mgottschlag/tiltrotor-uav/software/firmware/README.md

# Flightcontroller

## Setup on Archlinux

```bash
sudo pacman -S stlink
```

## Build and Run

```bash
# build
cargo build-flightcontroller

# run
cargo run-flightcontroller
```
