mgottschlag/tiltrotor-uav/doc/pre-design/pre-design.pdf

# Pre-Design of the Tiltrotor UAV

## 18th July 2021

## Contents

1 Requirements | 2
2 Overall Design | 2
3 Wing Design | 2
4 Empennage Design | 3

1

## 1 Requirements

- The UAV shall be able to take off and land vertically.
- The UAV shall be able to transition from the vertical flight to the horizontal flight and vice versa.
- The UAV shall fit into the Category C0 (privately built) [1]:

– The UAV shall have a MTOW of less than 250 g.
– The UAV shall have a maximum speed of less than 19 m s⁻¹ .
•

### 1.1 Vertical Flight

- Vertical flight only necessary for take-off and landing
- No fast manoeuvres necessary

### 1.2 Horizontal Flight

- The UAV shall be optimized for efficient flight at slow speed.
- The manoeuvrability shall suffice for basic manoeuvres. The ability to perform acrobatics is not necessary.

## 2 Overall Design

- The basic design is a conventional layout with a high wing with a high aspect ratio and a conventional tailplane.
- The motors are situated in front and in the back of the wing.
- The motors can be turned to perform the transition between vertical and horizontal flight.
- The UAV is controlled using a rudder and an elevator. There are no ailerons.

## 3 Wing Design

- Wing properties:

– High aspect ratio for good efficiency.

– Rectangular planform with tapered tips. Reason:

2

b

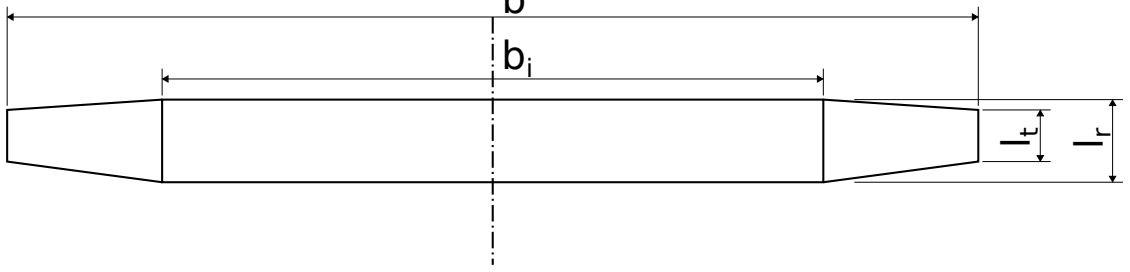
[picture p3: figure]

Figure 1: Wing planform

– The main part of the wing has no dihedral. Only the wing tips have a mod-erate dihedral as needed for stability.

- Wing surface:

S = bi

- lr +

b − bi
2

·

lr + lt
2
- Wing aspect ratio:
Λ = b

2
S
- Relative mean chord:
lµ = lr

This is only correct if the wing tips have no sweep.

## 4 Empennage Design

- The initial sizing of the empennage is done with the formulas given by Raymer [2,
p. 112].
- Both the vertical and horizontal tailplanes have a swept back leading edge and a straight trailing edge.
- Length of the mean aerodynamic chord with λi =

Lt,i

Lr,i

:

Lµ,i =

2
3
- Lr,i ·

1 + λi + λ

2
i
1 + λi
- y-position of the mean aerodynamic chord:

ylmu,i =

bi
6

·

1 + 2 · λi
1 + λi

3

### 4.1 Vertical Tail

SV T =

cV T · b · S

LV T
- The volume coefficient for the vertical tail is chosen as the one of a sailplane (cV T = 0.02).

### 4.2 Horizontal Tail

SHT =

cHT · lµ · S

LV T
- The volume coefficient for the horizontal tail is chosen as the one of a sailplane (cV T = 0.50).
- LV T is the distance of the 1
4

-point of the mean aerodynamic chord of the horizontal tailplane to the centre of gravity.

- lmu is the length of the mean aerodynamic chord of the horizontal tailplane.

4

## References

[1] Luftfahrt-Bundesamt. (). “Fragen und antworten zum eu-drohnenf¨uhrerschein,”
[Online]. Available: https://www.lba.de/DE/Betrieb/Unbemannte_Luftfahrtsysteme/FAQ/02_EU_Drohnenfuehrerschein/FAQ_node.html;jsessionid=3AB85C850216B1BFEEDFD691CD034F57. live21304 (https://www.lba.de/DE/Betrieb/Unbemannte_Luftfahrtsysteme/FAQ/02_EU_Drohnenfuehrerschein/FAQ_node.html;jsessionid=3AB85C850216B1BFEEDFD691CD034F57.live21304) (visited on 17/07/2021).
[2] D. P. Raymer, Aircraft Design: A Conceptual Approach. Washington, DC: American
Institute of Aeronautics ans Astronautics, Inc., 1992.

5
