mgottschlag/tiltrotor-uav/doc/pre-design/fig/wing_planform.pdf

b

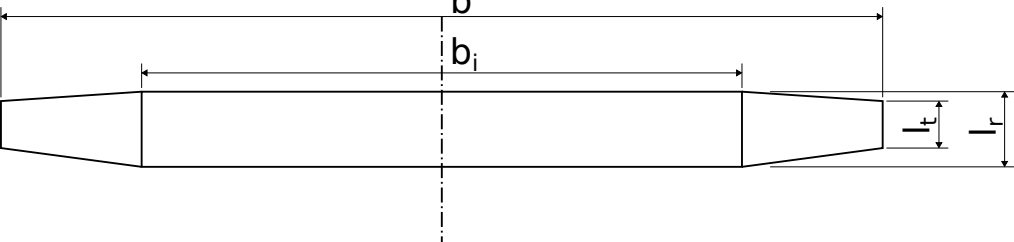
[picture p4: figure]
