mgottschlag/tiltrotor-uav/doc/pre-design/fig/Horizontal flight.PNG

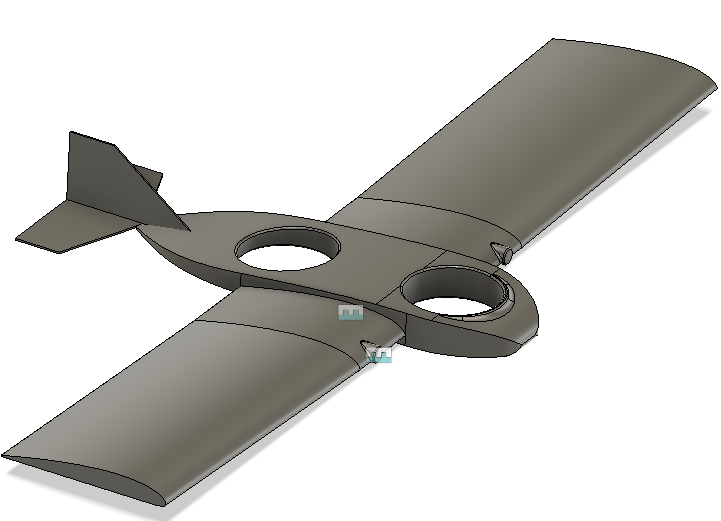
doc/pre-design/fig/Horizontal flight.PNG
