mgottschlag/tiltrotor-uav/doc/pre-design/fig/Vertical flight.PNG

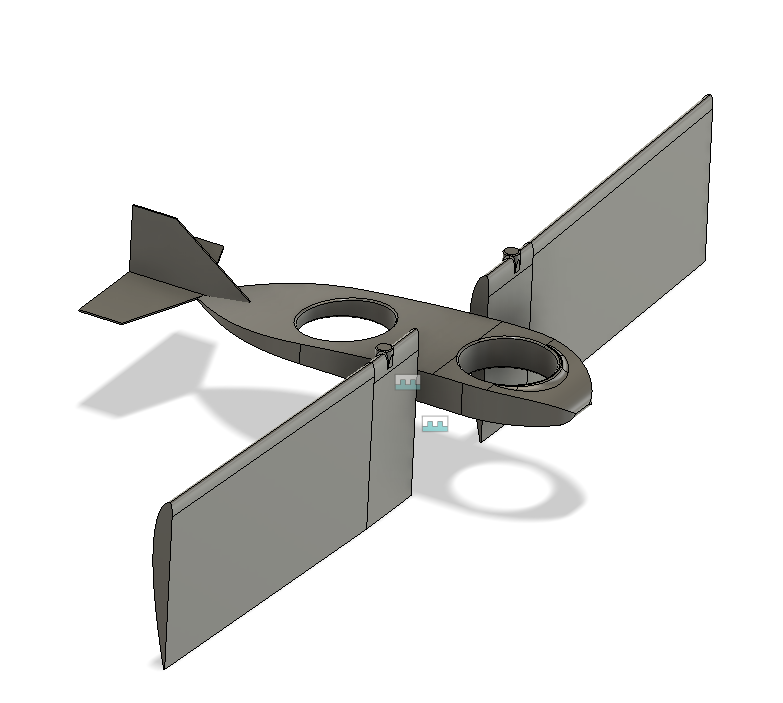
doc/pre-design/fig/Vertical flight.PNG
