mgottschlag/tiltrotor-uav/electronics/flightcontroller/flightcontroller.kicad_pcb

## KiCad design electronics/flightcontroller/flightcontroller.kicad_pcb (2024-06-04)

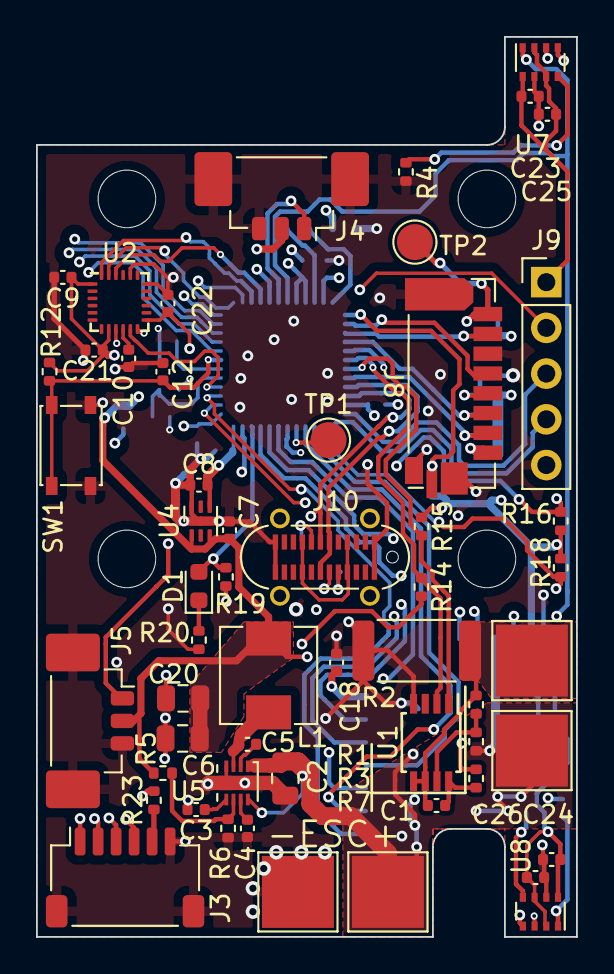
[picture p7: board flightcontroller.kicad_pcb from above]

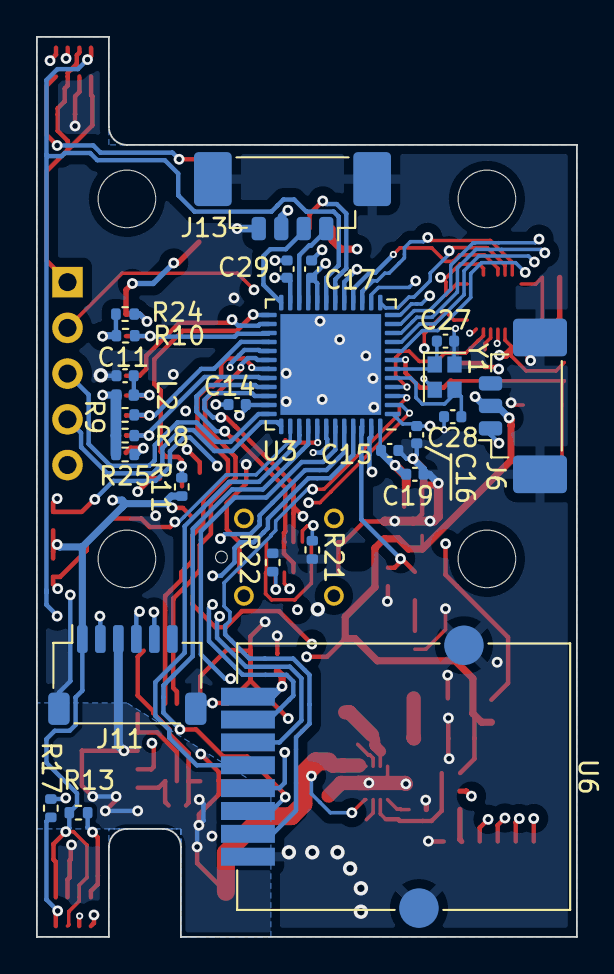
[picture p8: board flightcontroller.kicad_pcb from below]

Board: 4 copper layers, 30.0 x 50.0 mm, 85 parts (26 on the bottom side), 65 nets.

Parts:
C1, C5, C9, C10, C12, C14, C15, C16, C21, C22, C29: 0.1uF; C_0402_1005Metric
C2: 10uF/25V; C_0805_2012Metric
C3: 3300pF; C_0402_1005Metric
C4: 1uF/10V; C_0402_1005Metric
C6, C20: 22uF/6.3V; C_0805_2012Metric
C7: 1uF/25V; C_0402_1005Metric
C8, C11, C18, C19, C23, C24, C25, C26: 10uF/6.3V; C_0402_1005Metric
C17: 10uF; C_0402_1005Metric
C27, C28: 6.8pF; C_0402_1005Metric
D1: LED; LED_0603_1608Metric
H1, H2, H3, H4: MountingHole; MountingHole_3.2mm_M3_ISO7380
J1: BAT+; TestPoint_Pad_4.0x4.0mm
J2: ESC+; TestPoint_Pad_4.0x4.0mm
J3: ESC; JST_SH_SM06B-SRSS-TB_1x06-1MP_P1.00mm_Horizontal
J4: Servo3; Molex_PicoBlade_53398-0371_1x03-1MP_P1.25mm_Vertical
J5: Servo2; Molex_PicoBlade_53398-0371_1x03-1MP_P1.25mm_Vertical
J6: Servo1; Molex_PicoBlade_53398-0371_1x03-1MP_P1.25mm_Vertical
J7: ESC-; TestPoint_Pad_4.0x4.0mm
J8: Micro_SD_Card_Det_HYC80-TF08-XXX; HYC80-TF08-XXX
J9: SWD; PinHeader_1x05_P2.54mm_Vertical
J10: USB; USB_C_Receptacle_Amphenol_12402032
J11: Payload; JST_SH_SM06B-SRSS-TB_1x06-1MP_P1.00mm_Horizontal
J12: BAT-; TestPoint_Pad_4.0x4.0mm
J13: Conn_01x04; Molex_PicoBlade_53398-0471_1x04-1MP_P1.25mm_Vertical
L1: 3.3uH; L_AVX_LMLP0506D
L2: 600R@100MHz; L_0402_1005Metric
R1, R4, R12, R13, R17: 10k; R_0402_1005Metric
R2: 0.001; R_2512_6332Metric
R3: 20k; R_0402_1005Metric
R5: 68k; R_0402_1005Metric
R6: 16k; R_0402_1005Metric
R7: 470; R_0402_1005Metric
R8, R9, R10, R11, R19, R24, R25: 47k; R_0402_1005Metric
R14, R15, R16, R18: 4.7k; R_0402_1005Metric
R20: 1k; R_0402_1005Metric
R21, R22: 5.1k; R_0402_1005Metric
R23: DNP; R_0402_1005Metric
SW1: RESET; SW_SPST_PTS815
TP1: SWO; TestPoint_Pad_D2.0mm
TP2: DAT1; TestPoint_Pad_D2.0mm
U1: DS2745U; TSSOP-8_3x3mm_P0.65mm
U2: MPU-9250; InvenSense_QFN-24_3x3mm_P0.4mm
U3: STM32G491CCUx; QFN-48-1EP_7x7mm_P0.5mm_EP5.6x5.6mm
U4: MIC5514-3.3; MLF-6-1EP_1.6x1.6mm_P0.5mm_EP0.5x1.26mm
U5: BD9D322QWZ; Rohm_BD9D322QWZ
U6: GT-24-Mini
U7, U8: Omron_2SMPB-02B; Omron_2SMPB
Y1: 24MHz; Crystal_SMD_2016-4Pin_2.0x1.6mm

Connections:
+3V3: C8.2, C9.1, C14.1, C15.1, C16.1, C17.1, C18.1, C19.1, C21.1, C22.1, C23.1, C24.1, C25.1, C26.1, C29.1, J9.1, J11.1, J13.3, L2.2, R8.1, R9.1, R10.1, R11.1, R12.1, R13.1, R14.1, R15.1, R16.1, R18.1, R23.2, R24.1, R25.1, U2.1 (RESV_VDDIO), U2.8 (VDDIO), U2.13 (VDD), U3.1 (VBAT), U3.20 (VREF+), U3.21 (VDDA), U3.23 (VDD), U3.35 (VDD), U3.48 (VDD), U4.4 (VOUT), U6.1 (VCC), U7.2 (~CS/VDDIO), U7.6 (VDDIO), U7.8 (VDD), U8.2 (~CS/VDDIO), U8.6 (VDDIO), U8.8 (VDD)
+4V: C6.2, C7.1, C20.2, J4.2, J5.2, J6.2, J11.2, L1.2, R5.1, R7.2, U4.1 (EN), U4.3 (VIN)
+BATT: C2.2, J1.1, J2.1, J11.3, R3.2, U5.1 (VIN), U5.8 (EN)
/MCU/GPS_RX: J13.2, U3.24 (PB11)
/MCU/GPS_TX: J13.1, U3.22 (PB10)
/MCU/IMU_FSYNC: U2.11 (FSYNC), U3.4 (PC15)
/MCU/IMU_INT: U2.12 (INT), U3.12 (PA4)
/MCU/IMU_MISO: U2.9 (AD0/MISO), U3.14 (PA6)
/MCU/IMU_MOSI: U2.24 (SDA/MOSI), U3.15 (PA7)
/MCU/IMU_SCLK: U2.23 (SCL/SCLK), U3.13 (PA5)
/MCU/IMU_~CS: U2.22 (~CS), U3.16 (PC4)
/MCU/OSCA: C27.1, U3.6 (PF1), Y1.1
/MCU/OSCB: C28.1, U3.5 (PF0), Y1.3
/MCU/PAYLOAD_RX: J11.5, U3.45 (PB7)
/MCU/PAYLOAD_TX: J11.4, U3.44 (PB6)
/MCU/PR_RST: R17.1, U3.19 (PB2), U7.1 (RST), U8.1 (RST)
/MCU/PR_SCL: R18.2, U3.38 (PA15), U7.4 (SCK/SCL), U8.4 (SCK/SCL)
/MCU/PR_SDA: R16.2, U3.47 (PB9), U7.3 (SDI/SDA), U8.3 (SDI/SDA)
/MCU/PWM_M1: J3.4, U3.8 (PA0)
/MCU/PWM_M2: J3.3, U3.9 (PA1)
/MCU/PWM_M3: J3.2, U3.10 (PA2)
/MCU/PWM_M4: J3.1, U3.11 (PA3)
/MCU/PWR_SCL: R15.2, U1.1 (SCL), U3.31 (PA9)
/MCU/PWR_SDA: R14.2, U1.2 (SDA), U3.30 (PA8)
/MCU/RADIO_CE: U3.2 (PC13), U6.2 (CE)
/MCU/RADIO_MISO: U3.40 (PC11), U6.6 (MISO)
/MCU/RADIO_MOSI: U3.43 (PB5), U6.5 (MOSI)
/MCU/RADIO_SCK: U3.39 (PC10), U6.4 (SCK)
/MCU/RADIO_~CS: U3.29 (PC6), U6.3 (~CS)
/MCU/RADIO_~IRQ: U3.3 (PC14), U6.7 (~IRQ)
/MCU/SD_CS: J8.2 (DAT3/CD), R8.2, U3.32 (PA10)
/MCU/SD_DET: J8.9 (DET1), R11.2, U3.25 (PB12)
/MCU/SD_MISO: J8.7 (DAT0), R10.2, U3.27 (PB14)
/MCU/SD_MOSI: J8.3 (CMD), R9.2, U3.28 (PB15)
/MCU/SD_SCK: J8.5 (CLK), U3.26 (PB13)
/MCU/SERVO_ELEV: J4.1, U3.18 (PB1)
/MCU/SERVO_ENG: J5.1, U3.42 (PB4)
/MCU/SERVO_RUD: J6.1, U3.17 (PB0)
/MCU/SWCLK: J9.4, U3.37 (PA14)
/MCU/SWDIO: J9.3, U3.36 (PA13)
/MCU/SWO: TP1.1, U3.41 (PB3)
/MCU/USBN: J10.A7 (D-), J10.B7 (D-), U3.33 (PA11)
/MCU/USBP: J10.A6 (D+), J10.B6 (D+), U3.34 (PA12)
/MCU/~RESET: C12.1, J9.2, R12.2, SW1.1, U3.7 (PG10)
/Power Management/-BATT: C1.2, J12.1, R1.1, R2.1, U1.5 (VSS), U1.6 (CTG)
GND: C2.1, C3.2, C4.2, C6.1, C7.2, C8.1, C9.2, C10.2, C11.2, C12.2, C14.2, C15.2, C16.2, C17.2, C18.2, C19.2, C20.1, C21.2, C22.2, C23.2, C24.2, C25.2, C26.2, C27.2, C28.2, C29.2, J3.6, J3.MP (MountPin), J4.3, J4.MP (MountPin), J5.3, J5.MP (MountPin), J6.3, J6.MP (MountPin), J7.1, J8.6 (VSS), J8.10 (DET2), J8.11 (SHIELD), J9.5, J10.A1 (GND), J10.A12 (GND), J10.B1 (GND), J10.B12 (GND), J11.6, J11.MP (MountPin), J13.4, J13.MP (MountPin), R2.2, R4.2, R6.2, R17.2, R19.2, R20.2, R21.1, R22.1, SW1.2, U1.4 (SNS), U2.18 (GND), U2.20 (RESV_GND), U3.49 (VSS), U4.6 (GND), U4.7 (EP), U5.4 (GND), U5.9 (EP), U6.8 (GND), U6.9 (GND), U6.10 (GND), U7.7 (GND), U8.7 (GND), Y1.2, Y1.4
unnamed: C1.1, R7.1, U1.8 (VDD)
unnamed: C3.1, U5.5 (SS)
unnamed: C4.1, U5.7 (VREG)
unnamed: C5.1, U5.2 (BOOT)
unnamed: C5.2, L1.1, U5.3 (SW)
unnamed: C10.1, U2.10 (REGOUT)
unnamed: C11.1, J8.4 (VDD), L2.1
unnamed: D1.1 (K), R20.1
unnamed: D1.2 (A), R19.1, U3.46 (PB8)
unnamed: J3.5, R23.1
unnamed: J8.1 (DAT2), R25.2
unnamed: J8.8 (DAT1), R24.2, TP2.1
unnamed: J10.A4 (VBUS), J10.A9 (VBUS), J10.B4 (VBUS), J10.B9 (VBUS)
unnamed: J10.A5 (CC1), R22.2
unnamed: J10.B5 (CC2), R21.2
unnamed: R1.2, R3.1, U1.7 (VIN)
unnamed: R4.1, U7.5 (SDO/ADDR)
unnamed: R5.2, R6.1, U5.6 (FB)
unnamed: R13.2, U8.5 (SDO/ADDR)
