mgottschlag/tiltrotor-uav/software/firmware/src/board/flightcontroller.rs

use super::EscDriver;

use embassy_stm32::Peri;
use embassy_stm32::gpio::Level;
use embassy_stm32::gpio::Output;
use embassy_stm32::gpio::OutputType;
use embassy_stm32::gpio::Speed;
use embassy_stm32::mode::Async;
use embassy_stm32::peripherals::USB_OTG_FS;
use embassy_stm32::peripherals::{PA5, PA6, PA7, PA9, PA10, TIM3, TIM5};
use embassy_stm32::spi::Config as SpiConfig;
use embassy_stm32::spi::Spi;
use embassy_stm32::time::Hertz;
use embassy_stm32::time::hz;
use embassy_stm32::timer::simple_pwm::PwmPin;
use embassy_stm32::timer::simple_pwm::SimplePwm;
use embassy_stm32::usart;
use embassy_stm32::usart::Config as UsartConfig;
use embassy_stm32::usart::HalfDuplexReadback;
use embassy_stm32::usart::Parity;
use embassy_stm32::usart::StopBits;
use embassy_stm32::usart::Uart;
use embassy_stm32::usb;
use embassy_stm32::{bind_interrupts, i2c, peripherals};
use embassy_usb::Builder;
use embassy_usb::class::cdc_acm::CdcAcmClass;
use embassy_usb::class::cdc_acm::State;
use static_cell::StaticCell;

// see https://github.com/betaflight/unified-targets/blob/master/configs/default/OPEN-REVO.config for pin map
// or  https://www.getfpv.com/lumenier-skitzo-flight-controller-powered-by-flightone.html for some general information
type RadioRx = Peri<'static, PA10>;
type RadioTx = Peri<'static, PA9>;
type ImuSck = Peri<'static, PA5>;
type ImuMiso = Peri<'static, PA6>;
type ImuMosi = Peri<'static, PA7>;

pub type ImuSpi = Spi<'static, Async>; // SPI1
pub type ImuCs = Output<'static>; // PA4
pub type RadioUart = Uart<'static, Async>; // USART1
pub type UsbClass = CdcAcmClass<'static, usb::Driver<'static, USB_OTG_FS>>;
pub type UsbDevice = embassy_usb::UsbDevice<'static, usb::Driver<'static, USB_OTG_FS>>;
pub type UsbReceiver =
    embassy_usb::class::cdc_acm::Receiver<'static, usb::Driver<'static, USB_OTG_FS>>;
pub type UsbSender = embassy_usb::class::cdc_acm::Sender<'static, usb::Driver<'static, USB_OTG_FS>>;
pub type EscDriverType = BlackpillEscDriver;

bind_interrupts!(struct Irqs {
    I2C1_EV => i2c::EventInterruptHandler<peripherals::I2C1>;
    I2C1_ER => i2c::ErrorInterruptHandler<peripherals::I2C1>;
    OTG_FS => usb::InterruptHandler<peripherals::USB_OTG_FS>;
    USART1 => usart::InterruptHandler<peripherals::USART1>;
});

static EP_OUT_BUFFER: StaticCell<[u8; 256]> = StaticCell::new();
static CONFIG_DESCRIPTOR: StaticCell<[u8; 256]> = StaticCell::new();
static BOS_DESCRIPTOR: StaticCell<[u8; 256]> = StaticCell::new();
static CONTROL_BUF: StaticCell<[u8; 64]> = StaticCell::new();
static STATE: StaticCell<State> = StaticCell::new();

pub struct Board {
    pub radio_uart: RadioUart,
    pub imu_spi: ImuSpi,
    pub imu_cs: ImuCs,
    pub usb_class: UsbClass,
    pub usb_device: UsbDevice,
    pub esc_driver: EscDriverType,
}

impl Board {
    pub fn init() -> Board {
        let mut config = embassy_stm32::Config::default();
        {
            use embassy_stm32::rcc::*;
            config.rcc.hse = Some(Hse {
                freq: Hertz(8_000_000),
                mode: HseMode::Oscillator,
            });
            config.rcc.pll_src = PllSource::HSE;
            config.rcc.pll = Some(Pll {
                prediv: PllPreDiv::DIV8,
                mul: PllMul::MUL336,
                divp: Some(PllPDiv::DIV2), // 8mhz / 4 * 168 / 2 = 168Mhz.
                divq: Some(PllQDiv::DIV7), // 8mhz / 4 * 168 / 7 = 48Mhz.
                divr: None,
            });
            config.rcc.ahb_pre = AHBPrescaler::DIV1;
            config.rcc.apb1_pre = APBPrescaler::DIV4;
            config.rcc.apb2_pre = APBPrescaler::DIV2;
            config.rcc.sys = Sysclk::PLL1_P;
            config.rcc.mux.clk48sel = mux::Clk48sel::PLL1_Q;
        }
        let p = embassy_stm32::init(config);

        // init usb connection
        let ep_out_buffer = EP_OUT_BUFFER.init([0; 256]);
        let config_descriptor = CONFIG_DESCRIPTOR.init([0; 256]);
        let bos_descriptor = BOS_DESCRIPTOR.init([0; 256]);
        let control_buf = CONTROL_BUF.init([0; 64]);
        let state = STATE.init(State::new());

        let mut config = usb::Config::default();
        config.vbus_detection = false;
        let driver = usb::Driver::new_fs(p.USB_OTG_FS, Irqs, p.PA12, p.PA11, ep_out_buffer, config);

        let mut config = embassy_usb::Config::new(0xdead, 0xcafe);
        config.manufacturer = Some("Instinctive Llama Solutions");
        config.product = Some("UAV");
        config.serial_number = Some("42");

        let mut usb_builder = Builder::new(
            driver,
            config,
            config_descriptor,
            bos_descriptor,
            &mut [],
            control_buf,
        );

        let usb_class = CdcAcmClass::new(&mut usb_builder, state, 64);
        let usb_device = usb_builder.build();

        // init radio
        let mut radio_uart_config = UsartConfig::default();
        radio_uart_config.baudrate = 100000;
        radio_uart_config.parity = Parity::ParityEven;
        radio_uart_config.stop_bits = StopBits::STOP2;
        let _radio_rx: RadioRx = p.PA10;
        let radio_tx: RadioTx = p.PA9;
        let radio_uart = Uart::new_half_duplex(
            p.USART1,
            radio_tx,
            Irqs,
            p.DMA2_CH7,
            p.DMA2_CH2,
            radio_uart_config,
            HalfDuplexReadback::Readback,
        )
        .unwrap();

        // init imu
        let imu_cs = Output::new(p.PA4, Level::High, Speed::VeryHigh);
        let imu_sck: ImuSck = p.PA5;
        let imu_miso: ImuMiso = p.PA6;
        let imu_mosi: ImuMosi = p.PA7;
        let mut imu_spi_config = SpiConfig::default();
        imu_spi_config.frequency = hz(1_000_000);
        let imu_spi = Spi::new(
            p.SPI1,
            imu_sck,
            imu_mosi,
            imu_miso,
            p.DMA2_CH3,
            p.DMA2_CH0,
            imu_spi_config,
        );

        // init esc driver
        let pwm_tim5 = SimplePwm::new(
            p.TIM5,
            Some(PwmPin::new(p.PA0, OutputType::PushPull)),
            None,
            Some(PwmPin::new(p.PA2, OutputType::PushPull)),
            None,
            hz(50),
            Default::default(),
        );
        let pwm_tim3 = SimplePwm::new(
            p.TIM3,
            None,
            None,
            Some(PwmPin::new(p.PB0, OutputType::PushPull)),
            Some(PwmPin::new(p.PB1, OutputType::PushPull)),
            hz(50),
            Default::default(),
        );
        let esc_driver = BlackpillEscDriver::init(pwm_tim5, pwm_tim3);

        Board {
            radio_uart,
            imu_spi,
            imu_cs,
            usb_class,
            usb_device,
            esc_driver,
        }
    }
}

pub struct BlackpillEscDriver {
    pwm_tim5: SimplePwm<'static, TIM5>,
    pwm_tim3: SimplePwm<'static, TIM3>,
    offset_tim5: u16,
    offset_tim3: u16,
}

impl BlackpillEscDriver {
    /// Create the ESC PWM driver for Blackpill.
    ///
    /// M1: PB0
    /// M2: PB1
    /// M3: PA0 (TX4, M3 seems to be broken on flightcontroller board)
    /// M4: PA2
    pub fn init(
        mut pwm_tim5: SimplePwm<'static, TIM5>,
        mut pwm_tim3: SimplePwm<'static, TIM3>,
    ) -> Self {
        {
            pwm_tim5.ch1().enable();
            pwm_tim5.ch3().enable();
        }
        {
            pwm_tim3.ch3().enable();
            pwm_tim3.ch4().enable();
        }
        let offset_tim5 = (pwm_tim5.max_duty_cycle() as f32 * 0.05) as u16;
        let offset_tim3 = (pwm_tim3.max_duty_cycle() as f32 * 0.05) as u16;
        Self {
            pwm_tim5,
            pwm_tim3,
            offset_tim5,
            offset_tim3,
        }
    }
}

impl EscDriver for BlackpillEscDriver {
    fn update(&mut self, thrust: [f32; 4]) {
        // M1 (PB0 @ TIM3)
        self.pwm_tim3
            .ch3()
            .set_duty_cycle(calc(thrust[0], self.offset_tim3));
        // M2 (PB1 @ TIM3)
        self.pwm_tim3
            .ch4()
            .set_duty_cycle(calc(thrust[1], self.offset_tim3));
        // M3 (PA0 @ TIM5)
        self.pwm_tim5
            .ch1()
            .set_duty_cycle(calc(thrust[2], self.offset_tim5));
        // M4 (PA2 @ TIM5)
        self.pwm_tim5
            .ch3()
            .set_duty_cycle(calc(thrust[3], self.offset_tim5));
    }
}

fn calc(input: f32, offset: u16) -> u16 {
    let clamped = f32::max(f32::min(input, 1.0), 0.0);
    (clamped * offset as f32) as u16 + offset
}
