mgottschlag/tiltrotor-uav/(commit log)

2021-07-25 firmware: Add some bluepill PWM code for engine control.
2021-07-30 [firmware] Implement PWM for blackpill (#2)
2021-08-14 First parts of the PCB design: Power supply and monitoring.
    [flightcontroller.kicad_pcb, flightcontroller.kicad_sch, power.kicad_sch]
2021-08-18 [firmware] Fix typo in comment
    [main.rs]
2021-08-21 electronics: Draft most of the flight controller schematics.
    The power supply part is not complete, and all connections to the MCU are
    missing.
    [flightcontroller.kicad_pcb, flightcontroller.kicad_sch, mcu.kicad_sch, power.kicad_sch, sensors.kicad_sch]
2021-08-21 electronics: Changed the 4V regulator and added some ordering codes.
    [flightcontroller.kicad_sch, mcu.kicad_sch, power.kicad_sch, sensors.kicad_sch]
2021-09-01 PCB: Added missing footprints and an SD card slot symbol.
2021-09-01 PCB: USB, micro SD, and many component changes.
    [flightcontroller.kicad_pcb, flightcontroller.kicad_sch, mcu.kicad_sch, power.kicad_sch, sensors.kicad_sch]
2021-09-02 electronics: General PCB layout and size, let pressure sensors use I2C.
    [flightcontroller.kicad_pcb, flightcontroller.kicad_sch, sensors.kicad_sch]
2021-09-03 electronics: Microcontroller connections, general component placement.
    [flightcontroller.kicad_pcb, flightcontroller.kicad_sch, mcu.kicad_sch, power.kicad_sch, sensors.kicad_sch]
2021-09-03 electronics: Fix remaining schematics ERC errors.
    [flightcontroller.kicad_pcb, flightcontroller.kicad_sch, mcu.kicad_sch, power.kicad_sch, sensors.kicad_sch]
2021-09-03 electronics: Fixed the reset switch footprint.
    [flightcontroller.kicad_sch, mcu.kicad_sch]
2021-09-04 electronics: Preliminary component placement.
    [flightcontroller.kicad_pcb]
2021-09-25 Switch from stm32f401 to stm32f411 (#4)
2021-09-26 electronics: Finished wiring of the flight controller PCB.
    [flightcontroller.kicad_pcb, flightcontroller.kicad_sch, mcu.kicad_sch, power.kicad_sch]
2021-09-26 electronics: Fix most design rule checker errors.
    [flightcontroller.kicad_pcb, flightcontroller.kicad_sch]
2021-10-10 electronics: Fixed most flightcontroller DRC errors.
    [flightcontroller.kicad_pcb, flightcontroller.kicad_sch, mcu.kicad_sch]
2021-10-20 electronics: Add a resistor for ESC power and some test pads.
    [flightcontroller.kicad_pcb, flightcontroller.kicad_sch, mcu.kicad_sch, power.kicad_sch, sensors.kicad_sch]
2021-10-20 electronics: Placed missing resistors and fixed remaining DRC errors.
    [flightcontroller.kicad_pcb, flightcontroller.kicad_sch, mcu.kicad_sch, power.kicad_sch, sensors.kicad_sch]
2021-10-20 electronics: Add a radius to concave outline corners.
    [flightcontroller.kicad_pcb]
2022-01-01 Add files via upload
    Flächen und Leitwerksberechnung
    [Flächen und Leitwerksberechnung.xlsx]
2022-01-23 Update stm32f1xx-hal and stm32f4xx-hal to latest versions (#5)
2022-01-24 Support stm32g491 as flightcontroller (#6)
2022-01-25 Drop support for sm32f1xx and stm32f4xx as flightcontroller for now (#9)
2022-02-21 [firmware] Implement simple PID controller based balancing (#15)
2024-03-13 firmware: move pid to dedicated file
2024-03-18 remote: replace serde_cbor by ciborium
    [main.rs, radio.rs]
2024-03-30 remote: fix gamepad command handling
    [main.rs]
2024-04-05 firmware: read battery voltage and show on display
2024-04-05 software: return battery voltage along with status
2024-04-07 firmware: update engine pin settings
2024-04-07 firmware: prepare port mappings for storage and imu
2024-04-07 firmware: prepare port mappings pwm channels
2024-04-12 firmware: introduce sdcard-based trace file
2024-04-27 electronics: Production file settings.
    [flightcontroller.kicad_pcb]
2024-05-19 Hide different engine pwm implementations behind trait
2024-05-19 firmware: add error handling for radio
    [main.rs, radio.rs]
2024-05-24 firmware: add error handling for display (#17)
    [main.rs]
2024-06-08 firmware: slightly improve error handling of trace
2024-06-10 firmware: slightly further improve error handling
    [main.rs]
2024-06-11 software: replace serde_cbor by minicbor
    [main.rs, radio.rs]
2024-06-21 remote: add battery status to ui
2024-06-22 remote: improve error handling of radio implementation
    [main.rs, radio.rs]
2025-03-27 firmware: hide device init behind dedicated features
2025-04-03 software: rework creating motor commands
    [main.rs, radio.rs]
2025-04-03 software: move motor handling to dedicated crate
2025-04-15 firmware: basic motor control
2025-04-17 firmware: cleanup outdated boards
2025-06-10 Setup environment to flash flightcontroller to board
2025-11-15 Cleanup some prototype leftovers
2025-12-20 firmware: cleanup motor setup
2025-12-20 firmware: remove motor crate
2025-12-23 firmware: add remote to directly control motors
2025-12-26 firmware: setup pins for motor pwm
2025-12-28 firmware: find alternative for broken M3 pin
    [flightcontroller.rs]
2025-12-28 firmware: set thrust via pwm
2026-03-14 software: send imu status data to remote (#19)
2026-03-15 remote: write imu measurements to json file
2026-03-22 software: fix transmitting imu debug data via usb
    [decoder.rs, main.rs]
